Uberibsen/AstralisLEDSign/images/Printed_PCB.jpg

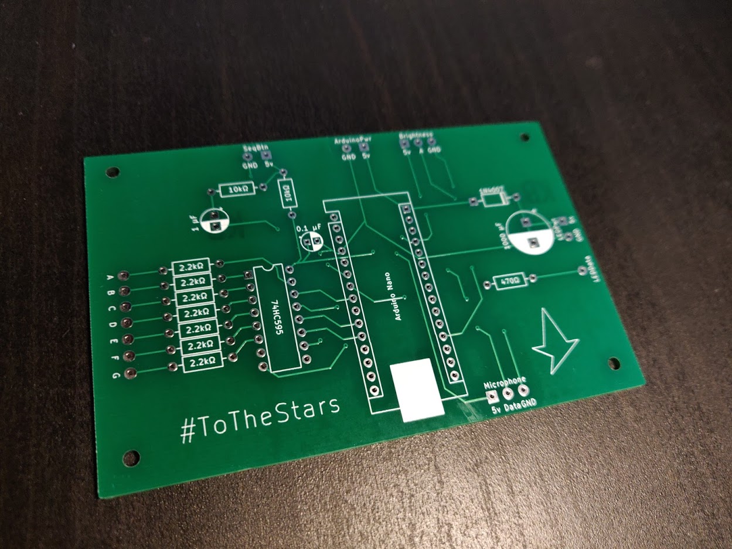
images/Printed_PCB.jpg
