Uberibsen/AstralisLEDSign/images/Control_box.jpg

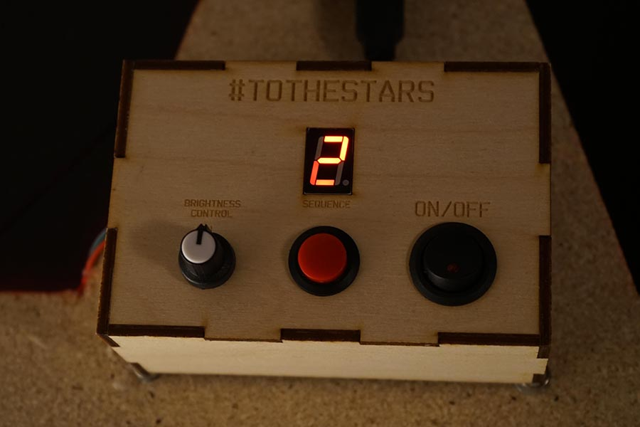
images/Control_box.jpg
