Uberibsen/AstralisLEDSign/images/Sign_back.jpg

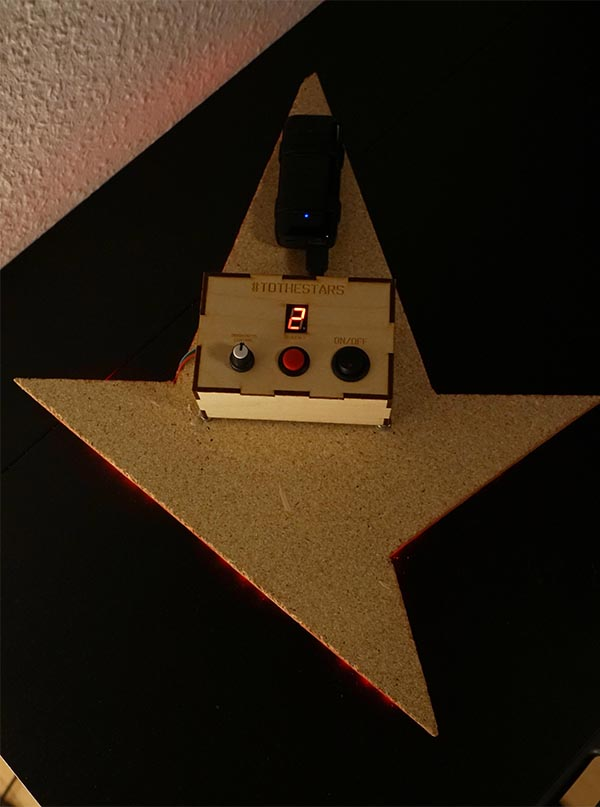
images/Sign_back.jpg
