Uberibsen/AstralisLEDSign/images/Sign_back_panel_off.jpg

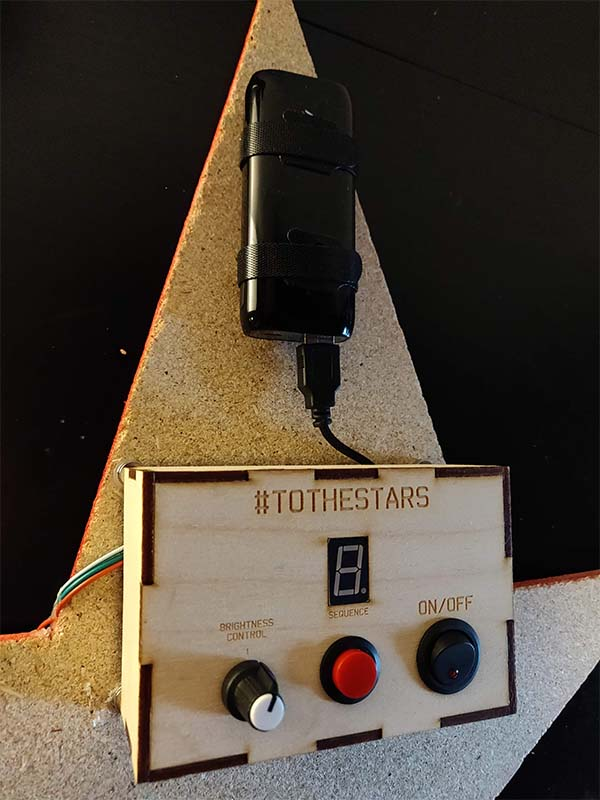
images/Sign_back_panel_off.jpg
