Uberibsen/AstralisLEDSign/images/Sign_buttom.jpg

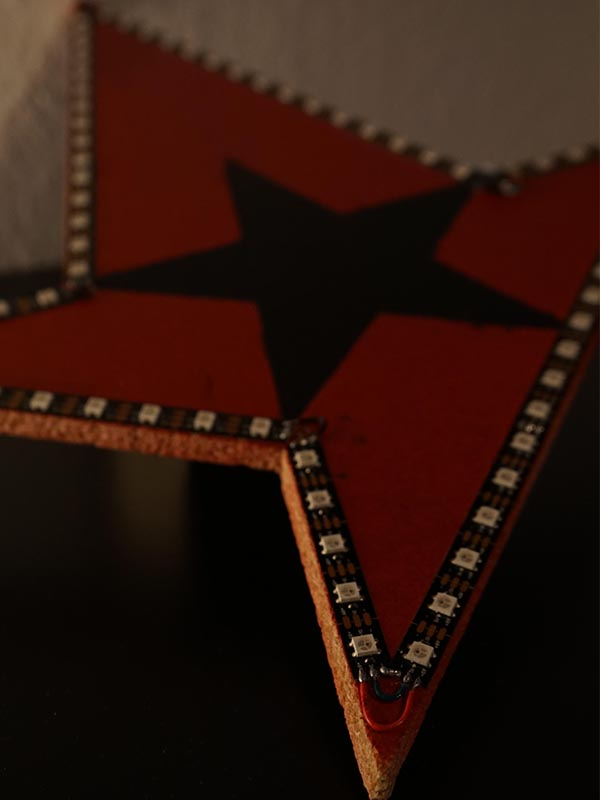
images/Sign_buttom.jpg
