Uberibsen/AstralisLEDSign/images/Sign_front.jpg

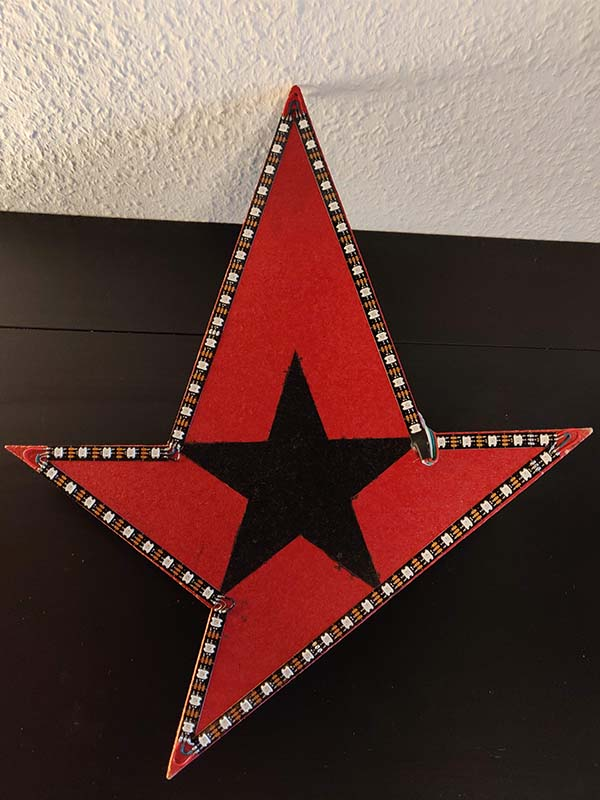
images/Sign_front.jpg
