Uberibsen/AstralisLEDSign/Schematic.pdf

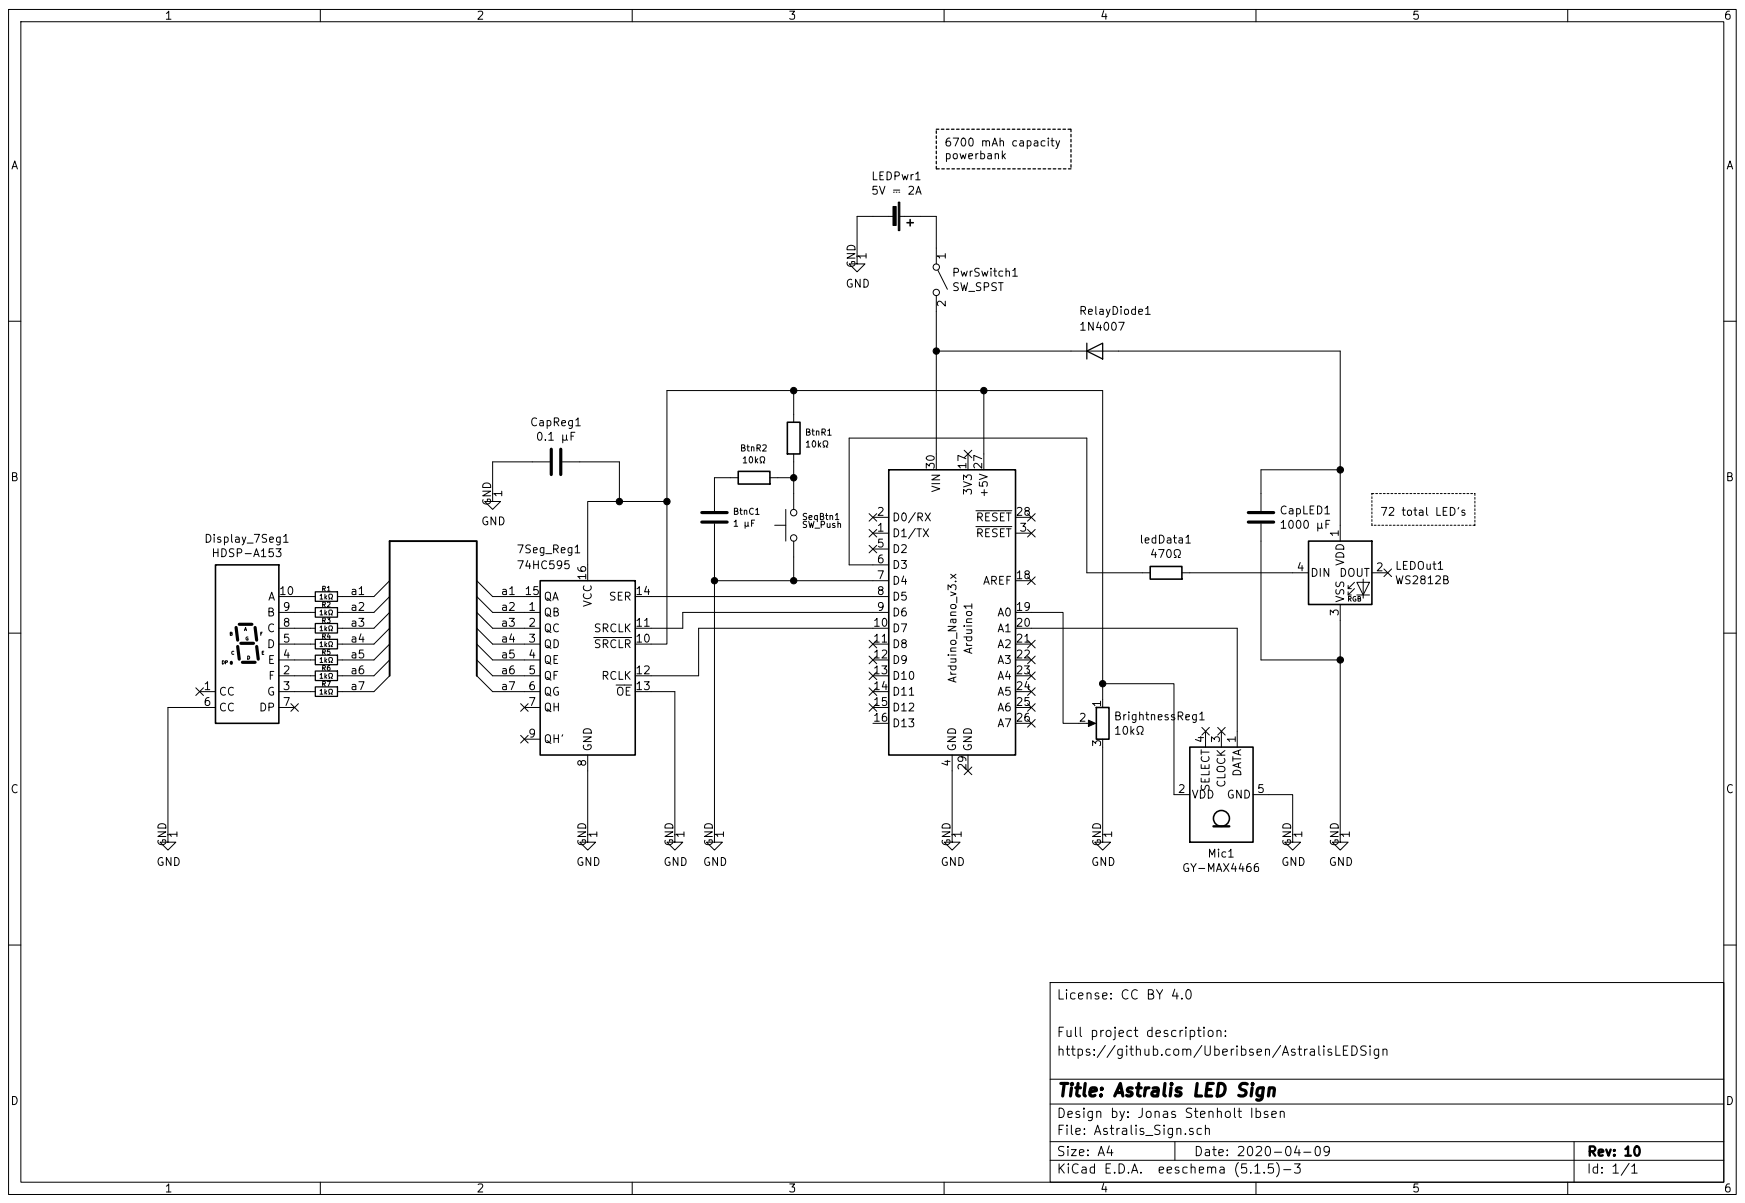
[picture p7: page 1]
