Uberibsen/AstralisLEDSign/(threads)

Thread 1 (2020-02-15):

Button push only being registered between loops

Uberibsen, 2020-02-15:
In the current code, the sequence button only increments `sequenceNumber` by one in between the loops when pressed.

### Possible solution
The ideal solution would be that no matter where the effect is in its duration (for loops, i.e.), the button push would be registered.  The fix would have to implement the code below into the for loops running in each effect.

```
buttonState = digitalRead(buttonPin);

  if (buttonState != lastButtonState) {
    if (buttonState == HIGH) {
      sequenceNumber++;
    }
    delay(50);
  }
  // save the current state as the last state, for next time through the loop
  lastButtonState = buttonState;
```

This iteration of the code runs that the individual effect would have to finish before it goes back around to register a button push.

Duckapple, 2020-02-17:
The problem with the unresponsive button is the fact that every light routine is carried out in its entirety before returning to the core loop again.
To alleviate this, you should try to query and update some state variable outside of the loop instead of iterating in the for loops.

An example:
```c++
//// before ////
void routine() {
    for (int i = 0; i < 10000; i++) { // Runs for 10 * 10000 = 100 seconds
        blink_light(i % 2); // alternates 0 and 1
        delay(10);
    }
}

void loop() {
    checkButton();
    routine();
}

//// after ////
int i = 0;

void routine() {
    if (i >= 10000) { // check whether to reset 'i'
        i = 0;
    } // could also just do the line: i = i % 10000
    blink_light(i % 2);
    i++;
}

void loop() {
    checkButton();
    routine();
    delay(10); // moved to loop for a global clock
}

Uberibsen, 2020-02-21:
Closed by ce3b18f2a623b125571f4222db1db631e753e06b

Closed 2020-02-21.

Thread 4 (2020-03-07):

Reactive lights with microphone module

Uberibsen, 2020-03-07:
A feature that would be cool to add would be the addition of a microphone to get the lights to react to the sounds of the arena. The setup would be rather simple since a [module](https://www.amazon.co.uk/ANGEEK-Detection-Microphone-Transmitter-Arduino/dp/B07JZBL8L5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) already exists, with adjustable gain. 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

### Approach
Many [similar projects](https://create.arduino.cc/projecthub/buzzandy/music-reactive-led-strip-5645ed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) have already been made with the WS2812 strip. However, for this project, frequency does not play a major factor since the arena would be loud in general. The lights would then only have to react to the dB (loudness) level, similar to [this project](https://create.arduino.cc/projecthub/electropeak/how-to-use-ky-037-sound-detection-sensor-with-arduino-a757a7).

Uberibsen, 2020-04-09:
The code has been written and ready for testing as soon as the hardware arrives in the mail.

Uberibsen, 2020-05-01:
Microphone feature added in merge 301980c

Closed 2020-05-01.
