Uberibsen/AstralisLEDSign/(commit log)

2020-01-21 Schematic for the PCB
2020-01-25 Button counter
2020-02-15 Updated schematic.
2020-02-21 Fixed seven segment display. Closes #3.
    [sign.ino]
